wulffern/sun_sar9b_sky130nm/design/SUN_SAR9B_SKY130NM/SUNSAR_SARBSSW_CV.md

Standard boostrapped switch. See [The Bootstrapped Switch - A circuit for All
Seasons](https://ieeexplore.ieee.org/document/7258484)  
for a good explanation of bootstrapped switches
