wulffern/sun_sar9b_sky130nm/design/SUN_SAR9B_SKY130NM/SUNSAR_SARCMPHX1_CV.md

Comparator half circuit. Drawn as a half circuit to get the parasitics exactly
the same.
