wulffern/sun_sar9b_sky130nm/design/SUN_SAR9B_SKY130NM/SUNSAR_SARCMPX1_CV.md

Strong arm comparator with kickback compensation.
