wulffern/sun_sar9b_sky130nm/sim/rtl/tb_sar.sv

`timescale 1 ns / 1 ps

module test;

  logic reset = 0;

  logic clk = 0;
  always #5 clk = !clk;


  logic [7:0] count;

  sar adc1 (.SAR_IP(vip), .SAR_IN(vin), .SARN(vn), .SARP(vp), .DONE(done),  )


  initial
    begin
       $dumpfile("counter.vcd");
       $dumpvars(0,test);

       #10 reset = 1;
       #10 reset = 0;

       #2600 $stop;

    end
endmodule // test
