wulffern/sun_sar9b_sky130nm/(commit log)

2022-11-13 Added SAR
    [SUNSAR_CAP32C_CV.sch, SUNSAR_CAP_BSSW5_CV.sch, SUNSAR_CAP_BSSW_CV.sch, SUNSAR_CDAC8_CV.sch, SUNSAR_DMY_CV.sch, SUNSAR_IVX1_CV.sch, SUNSAR_IVX4_CV.sch, SUNSAR_NCHDL.sch]
2023-04-10 Trying to get hierarchical LVS on SAR correct
    [SUNSAR_CAP_BSSW_CV.sch, SUNSAR_RM1.sch]
2023-04-14 Added SAR lpe
    [SUNSAR_CAP_BSSW5_CV.sch, SUNSAR_CAP_BSSW_CV.sch, SUNSAR_RM1.sch, SUNSAR_SARBSSW_CV.sch, SUNSAR_TGPD_CV.sch]
2024-02-19 Added 8B SAR
    [SUNSAR_SAR9B_CV.sch, SUNSAR_SARCMPX1_CV.sch]
2024-02-19 Fixed SAR
    [SUNSAR_ANX1_CV.sch, SUNSAR_BFX1_CV.sch, SUNSAR_CAP32C_CV.sch, SUNSAR_CAP_BSSW5_CV.sch, SUNSAR_CAP_BSSW_CV.sch, SUNSAR_CDAC7_CV.sch, SUNSAR_CDAC8_CV.sch, SUNSAR_DFRNQNX1_CV.sch]
2024-02-19 Updated tapcells for DF
    [SUNSAR_DFRNQNX1_CV.sch]
2024-02-20 Reduced size of SAR
    [SUNSAR_CAP_BSSW_CV.sch, SUNSAR_DFRNQNX1_CV.sch, SUNSAR_RM1.sch, SUNSAR_SAR8B_CV.sch, SUNSAR_SARCAPTURE_CV.sch]
2024-02-23 Updated SAR8B
    [SUNSAR_DFRNQNX1_CV.sch, SUNSAR_SARCAPTURE_CV.sch]
2024-02-23 LVS clean
    [SUNSAR_CAPT8B_CV.sch, SUNSAR_DFQNX1_CV.sch]
2024-02-26 Added TIE_L for outputs
    [SUNSAR_CAPT8B_CV.sch]
2024-04-11 Added back antenna transition
